mattthebaker/ewall-board/ClimbingWallController.brd

## EAGLE design ClimbingWallController.brd (2013-03-25)

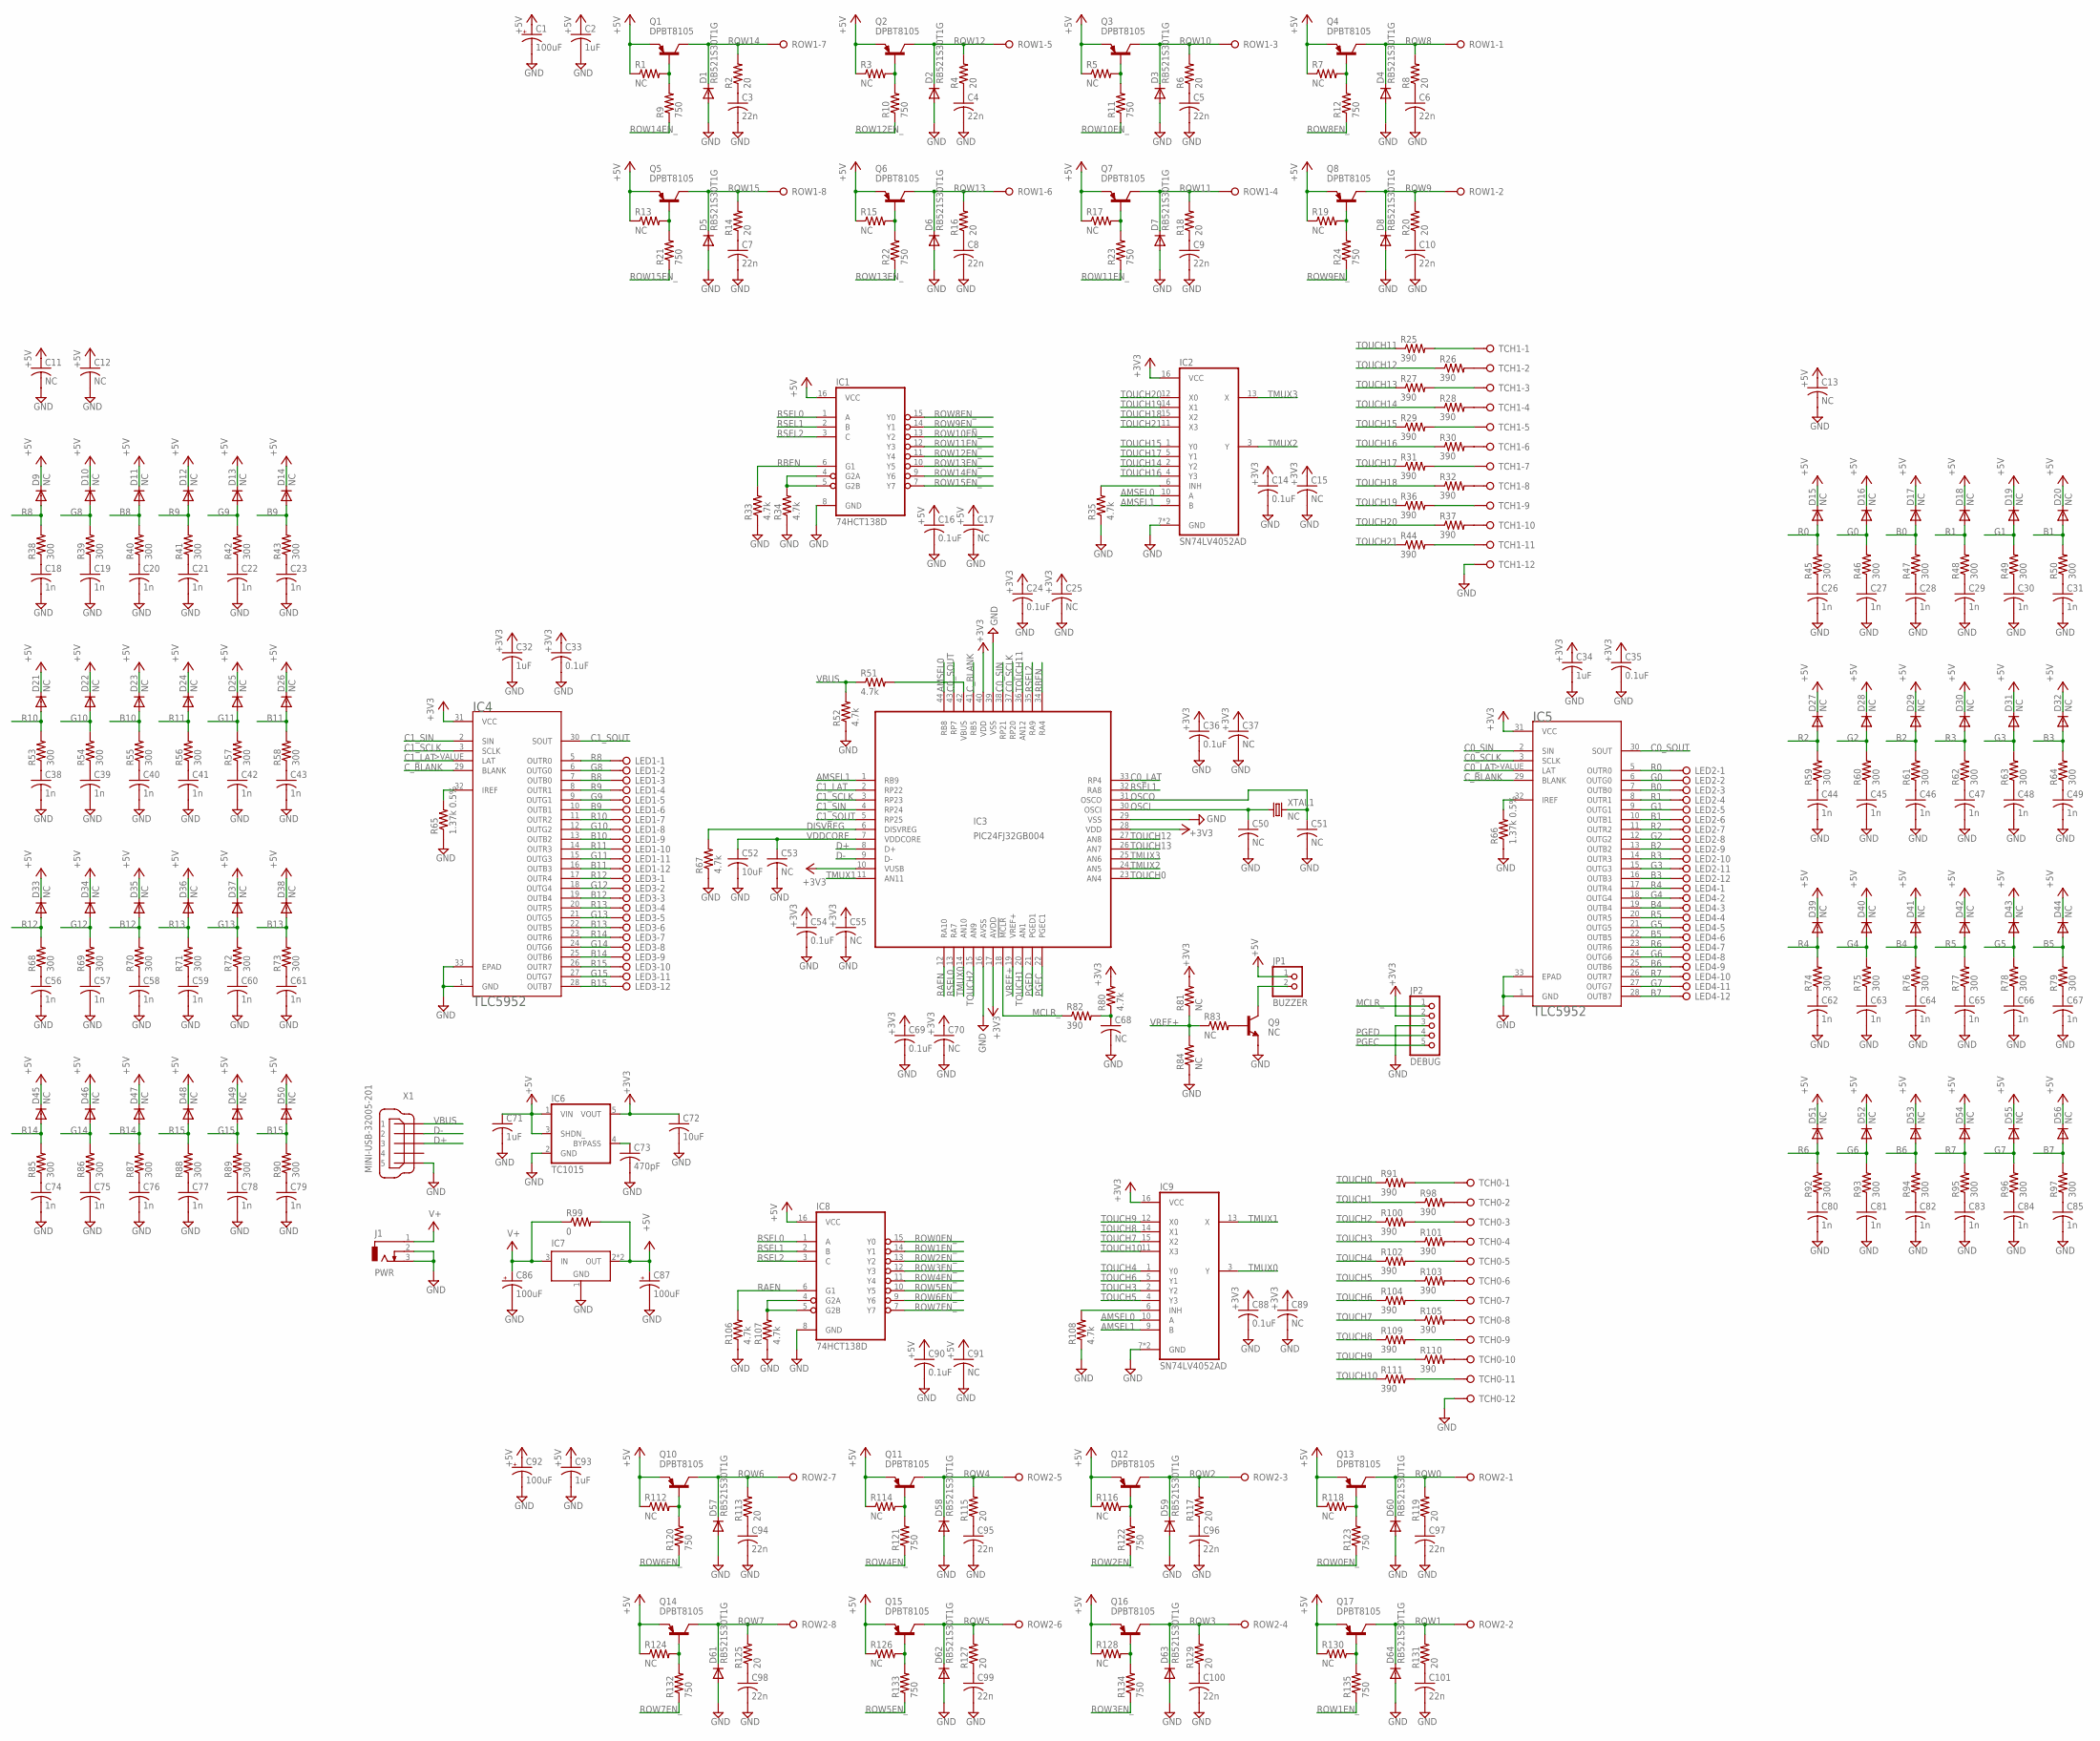
[picture p1: schematic ClimbingWallController.sch]

Parts:
C1, C86, C87, C92: 100uF; PANASONIC_D
C2, C32, C34, C71, C93: 1uF; C0603K
C3, C4, C5, C6, C7, C8, C9, C10, C94, C95, C96, C97, C98, C99, C100, C101: 22n; C0603K
C11, C12, C13, C15, C17, C25, C37, C50, C51, C53, C55, C68, C70, C89, C91: NC; C0603K
C14, C16, C24, C33, C35, C36, C54, C69, C88, C90: 0.1uF; C0603K
C18, C19, C20, C21, C22, C23, C26, C27, C28, C29, C30, C31, C38, C39, C40, C41, C42, C43, C44, C45, C46, C47, C48, C49, C56, C57, C58, C59, C60, C61, C62, C63, C64, C65, C66, C67, C74, C75, C76, C77, C78, C79, C80, C81, C82, C83, C84, C85: 1n; C0603K
C52, C72: 10uF; C1206K
C73: 470pF; C0603K
D1, D2, D3, D4, D5, D6, D7, D8, D57, D58, D59, D60, D61, D62, D63, D64: RB521S30T1G; SOD523
D9, D10, D11, D12, D13, D14, D15, D16, D17, D18, D19, D20, D21, D22, D23, D24, D25, D26, D27, D28, D29, D30, D31, D32, D33, D34, D35, D36, D37, D38, D39, D40, D41, D42, D43, D44, D45, D46, D47, D48, D49, D50, D51, D52, D53, D54, D55, D56: NC; SOD523
IC1, IC8: 74HCT138D; SO16
IC2, IC9: SN74LV4052AD; SO16
IC3: PIC24FJ32GB004; TQFP44
IC4, IC5: TLC5952; HTSSOP-32POWERPAD
IC6: TC1015; SOT23-5L
IC7: NCP1117; SOT223
J1: PWR; DCJ0303
JP1: BUZZER; 1X02
JP2: DEBUG; 1X05
LED1, LED2, LED3, LED4: OSTVN12A150; OSTVN12
Q1, Q2, Q3, Q4, Q5, Q6, Q7, Q8, Q10, Q11, Q12, Q13, Q14, Q15, Q16, Q17: DPBT8105; SOT23
Q9: NC; SOT23-BEC
R1, R3, R5, R7, R13, R15, R17, R19, R81, R83, R84, R112, R114, R116, R118, R124, R126, R128, R130: NC; R0603
R2, R4, R6, R8, R14, R16, R18, R20, R113, R115, R117, R119, R125, R127, R129, R131: 20; R0603
R9, R10, R11, R12, R21, R22, R23, R24, R120, R121, R122, R123, R132, R133, R134, R135: 750; R0603
R25, R26, R27, R28, R29, R30, R31, R32, R36, R37, R44, R82, R91, R98, R100, R101, R102, R103, R104, R105, R109, R110, R111: 390; R0603
R33, R34, R35, R51, R52, R67, R80, R106, R107, R108: 4.7k; R0603
R38, R39, R40, R41, R42, R43, R45, R46, R47, R48, R49, R50, R53, R54, R55, R56, R57, R58, R59, R60, R61, R62, R63, R64, R68, R69, R70, R71, R72, R73, R74, R75, R76, R77, R78, R79, R85, R86, R87, R88, R89, R90, R92, R93, R94, R95, R96, R97: 300; R0603
R65, R66: 1.37k 0.5%; R0805; TOLERANCE 0.5%
R99: 0; R0805
ROW1, ROW2: OSTVN08A150; OSTVN08
TCH0, TCH1: OSTVN12A150; OSTVN12
X1: MINI-USB-32005-201; 32005-201; MPN USB-M26FTR
XTAL1: NC; NX5032; MPN 7A-12.000MAAJ-T

Connections:
+3V3: C14.1, C15.1, C24.1, C25.1, C32.1, C33.1, C34.1, C35.1, C36.1, C37.1, C54.1, C55.1, C69.1, C70.1, C72.1, C88.1, C89.1, IC2.16 (VCC), IC3.10 (VUSB), IC3.17 (AVDD), IC3.28 (VDD), IC3.40 (VDD), IC4.31 (VCC), IC5.31 (VCC), IC6.5 (VOUT), IC9.16 (VCC), JP2.2, R80.2, R81.2
+5V: C1.+, C2.1, C11.1, C12.1, C13.1, C16.1, C17.1, C71.1, C87.+, C90.1, C91.1, C92.+, C93.1, D9.C, D10.C, D11.C, D12.C, D13.C, D14.C, D15.C, D16.C, D17.C, D18.C, D19.C, D20.C, D21.C, D22.C, D23.C, D24.C, D25.C, D26.C, D27.C, D28.C, D29.C, D30.C, D31.C, D32.C, D33.C, D34.C, D35.C, D36.C, D37.C, D38.C, D39.C, D40.C, D41.C, D42.C, D43.C, D44.C, D45.C, D46.C, D47.C, D48.C, D49.C, D50.C, D51.C, D52.C, D53.C, D54.C, D55.C, D56.C, IC1.16 (VCC), IC6.1 (VIN), IC6.3 (SHDN_), IC7.2 (OUT), IC7.4 (OUT), IC8.16 (VCC), JP1.1, Q1.2 (E), Q2.2 (E), Q3.2 (E), Q4.2 (E), Q5.2 (E), Q6.2 (E), Q7.2 (E), Q8.2 (E), Q10.2 (E), Q11.2 (E), Q12.2 (E), Q13.2 (E), Q14.2 (E), Q15.2 (E), Q16.2 (E), Q17.2 (E), R1.1, R3.1, R5.1, R7.1, R13.1, R15.1, R17.1, R19.1, R99.2, R112.1, R114.1, R116.1, R118.1, R124.1, R126.1, R128.1, R130.1
AMSEL0: IC2.10 (A), IC3.44 (RB8), IC9.10 (A)
AMSEL1: IC2.9 (B), IC3.1 (RB9), IC9.9 (B)
B0: D17.A, IC5.7 (OUTB0), LED2.3, R47.2
B1: D20.A, IC5.10 (OUTB1), LED2.6, R50.2
B2: D29.A, IC5.13 (OUTB2), LED2.9, R61.2
B3: D32.A, IC5.16 (OUTB3), LED2.12, R64.2
B4: D41.A, IC5.19 (OUTB4), LED4.3, R76.2
B5: D44.A, IC5.22 (OUTB5), LED4.6, R79.2
B6: D53.A, IC5.25 (OUTB6), LED4.9, R94.2
B7: D56.A, IC5.28 (OUTB7), LED4.12, R97.2
B8: D11.A, IC4.7 (OUTB0), LED1.3, R40.2
B9: D14.A, IC4.10 (OUTB1), LED1.6, R43.2
B10: D23.A, IC4.13 (OUTB2), LED1.9, R55.2
B11: D26.A, IC4.16 (OUTB3), LED1.12, R58.2
B12: D35.A, IC4.19 (OUTB4), LED3.3, R70.2
B13: D38.A, IC4.22 (OUTB5), LED3.6, R73.2
B14: D47.A, IC4.25 (OUTB6), LED3.9, R87.2
B15: D50.A, IC4.28 (OUTB7), LED3.12, R90.2
C0_LAT: IC3.33 (RP4), IC5.>VALUE (LAT)
C0_SCLK: IC3.37 (RP20), IC5.3 (SCLK)
C0_SIN: IC3.38 (RP21), IC5.2 (SIN)
C0_SOUT: IC3.43 (RP7), IC5.30 (SOUT)
C1_LAT: IC3.2 (RP22), IC4.>VALUE (LAT)
C1_SCLK: IC3.3 (RP23), IC4.3 (SCLK)
C1_SIN: IC3.4 (RP24), IC4.2 (SIN)
C1_SOUT: IC3.5 (RP25), IC4.30 (SOUT)
CAIREF: IC5.32 (IREF), R66.2
CAIREF1: IC4.32 (IREF), R65.2
C_BLANK: IC3.41 (RB5), IC4.29 (BLANK), IC5.29 (BLANK)
D+: IC3.8 (D+), X1.3
D-: IC3.9 (D-), X1.2
DISVREG: IC3.6 (DISVREG), R67.2
G0: D16.A, IC5.6 (OUTG0), LED2.2, R46.2
G1: D19.A, IC5.9 (OUTG1), LED2.5, R49.2
G2: D28.A, IC5.12 (OUTG2), LED2.8, R60.2
G3: D31.A, IC5.15 (OUTG3), LED2.11, R63.2
G4: D40.A, IC5.18 (OUTG4), LED4.2, R75.2
G5: D43.A, IC5.21 (OUTG5), LED4.5, R78.2
G6: D52.A, IC5.24 (OUTG6), LED4.8, R93.2
G7: D55.A, IC5.27 (OUTG7), LED4.11, R96.2
G8: D10.A, IC4.6 (OUTG0), LED1.2, R39.2
G9: D13.A, IC4.9 (OUTG1), LED1.5, R42.2
G10: D22.A, IC4.12 (OUTG2), LED1.8, R54.2
G11: D25.A, IC4.15 (OUTG3), LED1.11, R57.2
G12: D34.A, IC4.18 (OUTG4), LED3.2, R69.2
G13: D37.A, IC4.21 (OUTG5), LED3.5, R72.2
G14: D46.A, IC4.24 (OUTG6), LED3.8, R86.2
G15: D49.A, IC4.27 (OUTG7), LED3.11, R89.2
GND: C1.-, C2.2, C3.2, C4.2, C5.2, C6.2, C7.2, C8.2, C9.2, C10.2, C11.2, C12.2, C13.2, C14.2, C15.2, C16.2, C17.2, C18.2, C19.2, C20.2, C21.2, C22.2, C23.2, C24.2, C25.2, C26.2, C27.2, C28.2, C29.2, C30.2, C31.2, C32.2, C33.2, C34.2, C35.2, C36.2, C37.2, C38.2, C39.2, C40.2, C41.2, C42.2, C43.2, C44.2, C45.2, C46.2, C47.2, C48.2, C49.2, C50.2, C51.2, C52.2, C53.2, C54.2, C55.2, C56.2, C57.2, C58.2, C59.2, C60.2, C61.2, C62.2, C63.2, C64.2, C65.2, C66.2, C67.2, C68.2, C69.2, C70.2, C71.2, C72.2, C73.2, C74.2, C75.2, C76.2, C77.2, C78.2, C79.2, C80.2, C81.2, C82.2, C83.2, C84.2, C85.2, C86.-, C87.-, C88.2, C89.2, C90.2, C91.2, C92.-, C93.2, C94.2, C95.2, C96.2, C97.2, C98.2, C99.2, C100.2, C101.2, D1.A, D2.A, D3.A, D4.A, D5.A, D6.A, D7.A, D8.A, D57.A, D58.A, D59.A, D60.A, D61.A, D62.A, D63.A, D64.A, IC1.8 (GND), IC2.7 (GND), IC2.8 (GND), IC3.16 (AVSS), IC3.29 (VSS), IC3.39 (VSS), IC4.1 (GND), IC4.33 (EPAD), IC5.1 (GND), IC5.33 (EPAD), IC6.2 (GND), IC7.1 (GND), IC8.8 (GND), IC9.7 (GND), IC9.8 (GND), J1.2, J1.3, JP2.3, Q9.E, R33.1, R34.1, R35.1, R52.1, R65.1, R66.1, R67.1, R84.1, R106.1, R107.1, R108.1, TCH0.12, TCH1.12, X1.5
MCLR_: IC3.18 (!MCLR), JP2.1, R82.1
unnamed: Q13.1 (B), R118.2, R123.2
unnamed: C97.1, R119.1
unnamed: Q12.1 (B), R116.2, R122.2
unnamed: C96.1, R117.1
unnamed: Q16.1 (B), R128.2, R134.2
unnamed: C100.1, R129.1
unnamed: Q15.1 (B), R126.2, R133.2
unnamed: C99.1, R127.1
unnamed: Q11.1 (B), R114.2, R121.2
unnamed: C95.1, R115.1
unnamed: Q10.1 (B), R112.2, R120.2
unnamed: C94.1, R113.1
unnamed: Q14.1 (B), R124.2, R132.2
unnamed: C98.1, R125.1
unnamed: Q8.1 (B), R19.2, R24.2
unnamed: C10.1, R20.1
unnamed: Q4.1 (B), R7.2, R12.2
unnamed: C6.1, R8.1
unnamed: Q3.1 (B), R5.2, R11.2
unnamed: C5.1, R6.1
unnamed: Q7.1 (B), R17.2, R23.2
unnamed: C9.1, R18.1
unnamed: Q6.1 (B), R15.2, R22.2
unnamed: C8.1, R16.1
unnamed: Q2.1 (B), R3.2, R10.2
unnamed: C4.1, R4.1
unnamed: Q1.1 (B), R1.2, R9.2
unnamed: C3.1, R2.1
unnamed: Q5.1 (B), R13.2, R21.2
unnamed: C7.1, R14.1
unnamed: R98.2, TCH0.2
unnamed: R101.2, TCH0.4
unnamed: Q17.1 (B), R130.2, R135.2
unnamed: C101.1, R131.1
unnamed: R103.2, TCH0.6
unnamed: R105.2, TCH0.8
unnamed: R110.2, TCH0.10
unnamed: R26.2, TCH1.2
unnamed: R28.2, TCH1.4
unnamed: R30.2, TCH1.6
unnamed: IC8.4 (G2A), IC8.5 (G2B), R107.2
unnamed: IC9.6 (INH), R108.2
unnamed: IC1.4 (G2A), IC1.5 (G2B), R34.2
unnamed: IC2.6 (INH), R35.2
unnamed: IC3.42 (VBUS), R51.2
unnamed: C68.1, R80.1, R82.2
unnamed: R91.2, TCH0.1
unnamed: R32.2, TCH1.8
unnamed: R37.2, TCH1.10
unnamed: Q9.B, R83.2
unnamed: R100.2, TCH0.3
unnamed: R102.2, TCH0.5
unnamed: R104.2, TCH0.7
unnamed: R109.2, TCH0.9
unnamed: R111.2, TCH0.11
unnamed: R25.2, TCH1.1
unnamed: R27.2, TCH1.3
unnamed: R29.2, TCH1.5
unnamed: R31.2, TCH1.7
unnamed: R36.2, TCH1.9
unnamed: R44.2, TCH1.11
unnamed: C73.1, IC6.4 (BYPASS)
unnamed: JP1.2, Q9.C
unnamed: C26.1, R45.1
unnamed: C27.1, R46.1
unnamed: C28.1, R47.1
unnamed: C29.1, R48.1
unnamed: C30.1, R49.1
unnamed: C31.1, R50.1
unnamed: C44.1, R59.1
unnamed: C45.1, R60.1
unnamed: C46.1, R61.1
unnamed: C47.1, R62.1
unnamed: C48.1, R63.1
unnamed: C49.1, R64.1
unnamed: C62.1, R74.1
unnamed: C63.1, R75.1
unnamed: C64.1, R76.1
unnamed: C65.1, R77.1
unnamed: C66.1, R78.1
unnamed: C67.1, R79.1
unnamed: C80.1, R92.1
unnamed: C81.1, R93.1
unnamed: C82.1, R94.1
unnamed: C83.1, R95.1
unnamed: C84.1, R96.1
unnamed: C85.1, R97.1
unnamed: C18.1, R38.1
unnamed: C19.1, R39.1
unnamed: C20.1, R40.1
unnamed: C21.1, R41.1
unnamed: C22.1, R42.1
unnamed: C23.1, R43.1
unnamed: C38.1, R53.1
unnamed: C39.1, R54.1
unnamed: C40.1, R55.1
unnamed: C41.1, R56.1
unnamed: C42.1, R57.1
unnamed: C43.1, R58.1
unnamed: C56.1, R68.1
unnamed: C57.1, R69.1
unnamed: C58.1, R70.1
unnamed: C59.1, R71.1
unnamed: C60.1, R72.1
unnamed: C61.1, R73.1
unnamed: C74.1, R85.1
unnamed: C75.1, R86.1
unnamed: C76.1, R87.1
unnamed: C77.1, R88.1
unnamed: C78.1, R89.1
unnamed: C79.1, R90.1
OSCI: C50.1, IC3.30 (OSCI), XTAL1.P$1 (1)
OSCO: C51.1, IC3.31 (OSCO), XTAL1.P$2 (2)
PGEC: IC3.22 (PGEC1), JP2.5
PGED: IC3.21 (PGED1), JP2.4
R0: D15.A, IC5.5 (OUTR0), LED2.1, R45.2
R1: D18.A, IC5.8 (OUTR1), LED2.4, R48.2
R2: D27.A, IC5.11 (OUTR2), LED2.7, R59.2
R3: D30.A, IC5.14 (OUTR3), LED2.10, R62.2
R4: D39.A, IC5.17 (OUTR4), LED4.1, R74.2
R5: D42.A, IC5.20 (OUTR5), LED4.4, R77.2
R6: D51.A, IC5.23 (OUTR6), LED4.7, R92.2
R7: D54.A, IC5.26 (OUTR7), LED4.10, R95.2
R8: D9.A, IC4.5 (OUTR0), LED1.1, R38.2
R9: D12.A, IC4.8 (OUTR1), LED1.4, R41.2
R10: D21.A, IC4.11 (OUTR2), LED1.7, R53.2
R11: D24.A, IC4.14 (OUTR3), LED1.10, R56.2
R12: D33.A, IC4.17 (OUTR4), LED3.1, R68.2
R13: D36.A, IC4.20 (OUTR5), LED3.4, R71.2
R14: D45.A, IC4.23 (OUTR6), LED3.7, R85.2
R15: D48.A, IC4.26 (OUTR7), LED3.10, R88.2
RAEN: IC3.12 (RA10), IC8.6 (G1), R106.2
RBEN: IC1.6 (G1), IC3.34 (RA4), R33.2
ROW0: D60.C, Q13.3 (C), R119.2, ROW2.1
ROW0EN_: IC8.15 (Y0), R123.1
ROW1: D64.C, Q17.3 (C), R131.2, ROW2.2
ROW1EN_: IC8.14 (Y1), R135.1
ROW2: D59.C, Q12.3 (C), R117.2, ROW2.3
ROW2EN_: IC8.13 (Y2), R122.1
ROW3: D63.C, Q16.3 (C), R129.2, ROW2.4
ROW3EN_: IC8.12 (Y3), R134.1
ROW4: D58.C, Q11.3 (C), R115.2, ROW2.5
ROW4EN_: IC8.11 (Y4), R121.1
ROW5: D62.C, Q15.3 (C), R127.2, ROW2.6
ROW5EN_: IC8.10 (Y5), R133.1
ROW6: D57.C, Q10.3 (C), R113.2, ROW2.7
ROW6EN_: IC8.9 (Y6), R120.1
ROW7: D61.C, Q14.3 (C), R125.2, ROW2.8
ROW7EN_: IC8.7 (Y7), R132.1
ROW8: D4.C, Q4.3 (C), R8.2, ROW1.1
ROW8EN_: IC1.15 (Y0), R12.1
ROW9: D8.C, Q8.3 (C), R20.2, ROW1.2
ROW9EN_: IC1.14 (Y1), R24.1
ROW10: D3.C, Q3.3 (C), R6.2, ROW1.3
ROW10EN_: IC1.13 (Y2), R11.1
ROW11: D7.C, Q7.3 (C), R18.2, ROW1.4
ROW11EN_: IC1.12 (Y3), R23.1
ROW12: D2.C, Q2.3 (C), R4.2, ROW1.5
ROW12EN_: IC1.11 (Y4), R10.1
ROW13: D6.C, Q6.3 (C), R16.2, ROW1.6
ROW13EN_: IC1.10 (Y5), R22.1
ROW14: D1.C, Q1.3 (C), R2.2, ROW1.7
ROW14EN_: IC1.9 (Y6), R9.1
ROW15: D5.C, Q5.3 (C), R14.2, ROW1.8
ROW15EN_: IC1.7 (Y7), R21.1
RSEL0: IC1.1 (A), IC3.13 (RA7), IC8.1 (A)
RSEL1: IC1.2 (B), IC3.32 (RA8), IC8.2 (B)
RSEL2: IC1.3 (C), IC3.35 (RA9), IC8.3 (C)
TMUX0: IC3.14 (AN10), IC9.3 (Y)
TMUX1: IC3.11 (AN11), IC9.13 (X)
TMUX2: IC2.3 (Y), IC3.24 (AN5)
TMUX3: IC2.13 (X), IC3.25 (AN6)
TOUCH0: IC3.23 (AN4), R91.1
TOUCH1: IC3.20 (AN1), R98.1
TOUCH2: IC3.15 (AN9), R100.1
TOUCH3: IC9.2 (Y2), R101.1
TOUCH4: IC9.1 (Y0), R102.1
TOUCH5: IC9.4 (Y3), R103.1
TOUCH6: IC9.5 (Y1), R104.1
TOUCH7: IC9.15 (X2), R105.1
TOUCH8: IC9.14 (X1), R109.1
TOUCH9: IC9.12 (X0), R110.1
TOUCH10: IC9.11 (X3), R111.1
TOUCH11: IC3.36 (AN12), R25.1
TOUCH12: IC3.27 (AN8), R26.1
TOUCH13: IC3.26 (AN7), R27.1
TOUCH14: IC2.2 (Y2), R28.1
TOUCH15: IC2.1 (Y0), R29.1
TOUCH16: IC2.4 (Y3), R30.1
TOUCH17: IC2.5 (Y1), R31.1
TOUCH18: IC2.15 (X2), R32.1
TOUCH19: IC2.14 (X1), R36.1
TOUCH20: IC2.12 (X0), R37.1
TOUCH21: IC2.11 (X3), R44.1
V+: C86.+, IC7.3 (IN), J1.1, R99.1
VBUS: R51.1, R52.2, X1.1
VDDCORE: C52.1, C53.1, IC3.7 (VDDCORE)
VREF+: IC3.19 (VREF+), R81.1, R83.1, R84.2

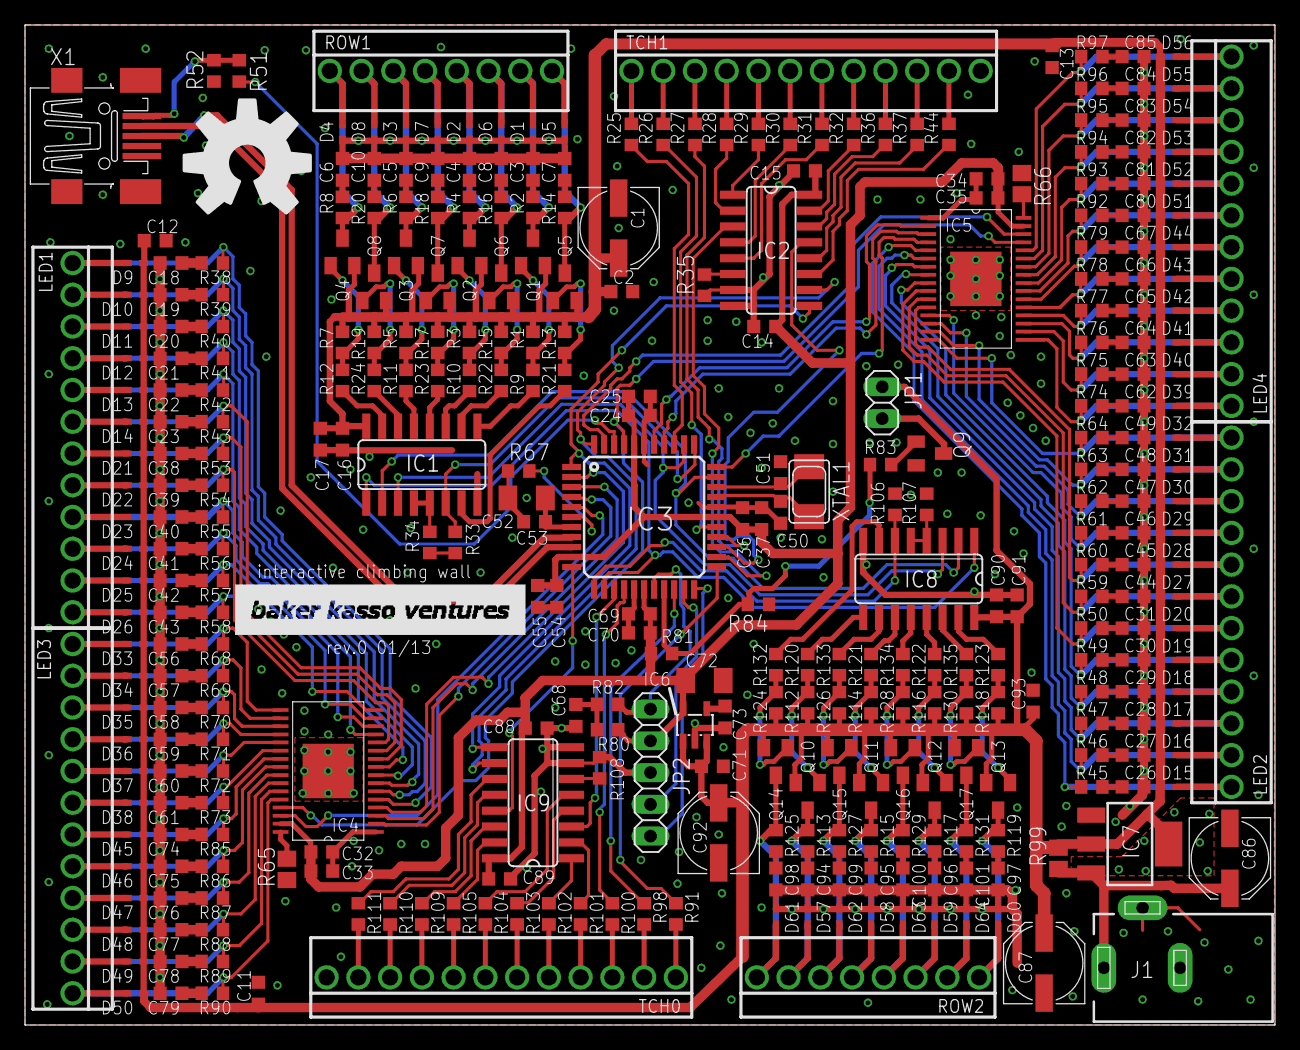
[picture p2: board ClimbingWallController.brd from above]

Board: 2 copper layers, 100.0 x 80.0 mm, 339 parts (0 on the bottom side), 250 nets.
