mattthebaker/ewall-board/RowDriver4.brd

## EAGLE design RowDriver4.brd (2013-01-11)

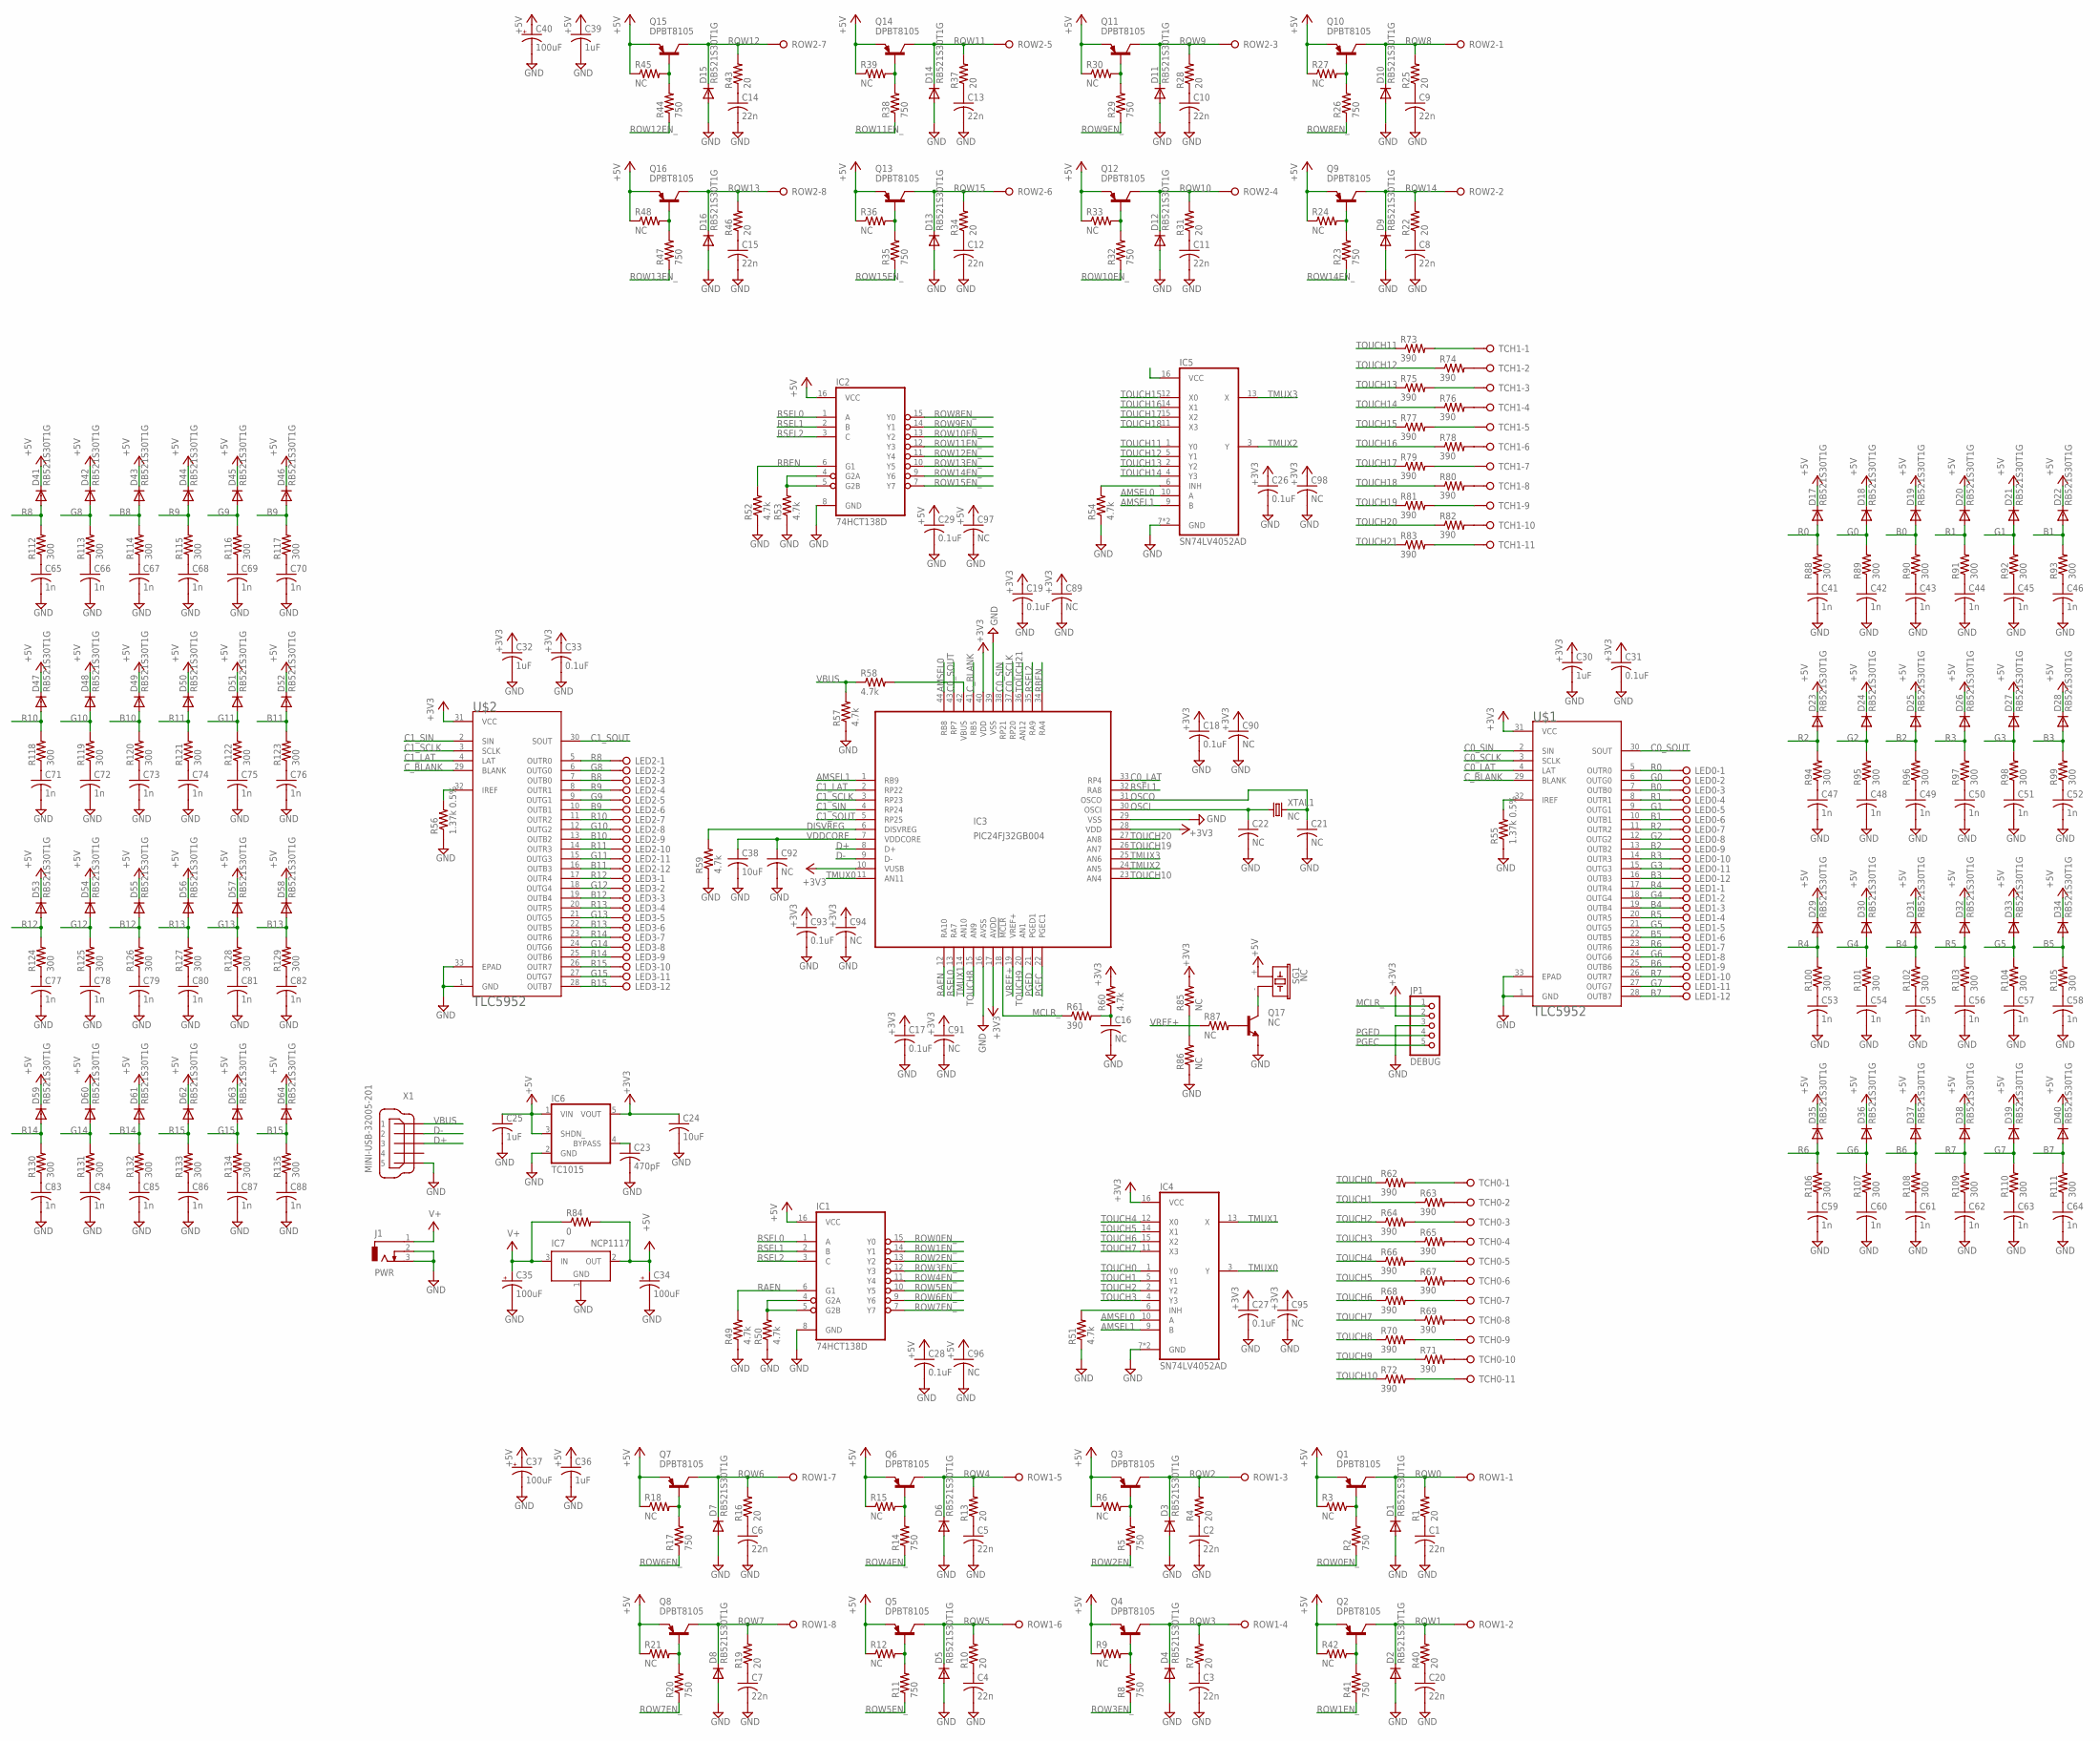
[picture p3: schematic RowDriver4.sch]

Parts:
C1, C2, C3, C4, C5, C6, C7, C8, C9, C10, C11, C12, C13, C14, C15, C20: 22n; C0603
C16, C21, C22, C89, C90, C91, C92, C94, C95, C96, C97, C98: NC; C0805
C17, C18, C19, C26, C27, C28, C29, C31, C33, C93: 0.1uF; C0805
C23: 470pF; C0805
C24, C38: 10uF; C1206K
C25, C30, C32, C36, C39: 1uF; C0805
C34, C35, C37, C40: 100uF; PANASONIC_D
C41, C42, C43, C44, C45, C46, C47, C48, C49, C50, C51, C52, C53, C54, C55, C56, C57, C58, C59, C60, C61, C62, C63, C64, C65, C66, C67, C68, C69, C70, C71, C72, C73, C74, C75, C76, C77, C78, C79, C80, C81, C82, C83, C84, C85, C86, C87, C88: 1n; C0805
D1, D2, D3, D4, D5, D6, D7, D8, D9, D10, D11, D12, D13, D14, D15, D16, D17, D18, D19, D20, D21, D22, D23, D24, D25, D26, D27, D28, D29, D30, D31, D32, D33, D34, D35, D36, D37, D38, D39, D40, D41, D42, D43, D44, D45, D46, D47, D48, D49, D50, D51, D52, D53, D54, D55, D56, D57, D58, D59, D60, D61, D62, D63, D64: RB521S30T1G; SOD523
IC1, IC2: 74HCT138D; SO16
IC3: PIC24FJ32GB004; TQFP44
IC4, IC5: SN74LV4052AD; SO16
IC6: TC1015; SOT23-5L
IC7: NCP1117; SOT223
J1: PWR; DCJ0303
JP1: DEBUG; 1X05/90
LED0, LED1, LED2, LED3: OSTVN12A150; OSTVN12
Q1, Q2, Q3, Q4, Q5, Q6, Q7, Q8, Q9, Q10, Q11, Q12, Q13, Q14, Q15, Q16: DPBT8105; SOT23
Q17: NC; SOT23-EBC
R1, R4, R7, R10, R13, R16, R19, R22, R25, R28, R31, R34, R37, R40, R43, R46: 20; R0603
R2, R5, R8, R11, R14, R17, R20, R23, R26, R29, R32, R35, R38, R41, R44, R47: 750; R0603
R3, R6, R9, R12, R15, R18, R21, R24, R27, R30, R33, R36, R39, R42, R45, R48: NC; R0603
R49, R50, R51, R52, R53, R54, R57, R58, R59, R60: 4.7k; R0805
R55, R56: 1.37k 0.5%; R0805
R61, R62, R63, R64, R65, R66, R67, R68, R69, R70, R71, R72, R73, R74, R75, R76, R77, R78, R79, R80, R81, R82, R83: 390; R0805
R84: 0; R0805
R85, R86, R87: NC; R0805
R88, R89, R90, R91, R92, R93, R94, R95, R96, R97, R98, R99, R100, R101, R102, R103, R104, R105, R106, R107, R108, R109, R110, R111, R112, R113, R114, R115, R116, R117, R118, R119, R120, R121, R122, R123, R124, R125, R126, R127, R128, R129, R130, R131, R132, R133, R134, R135: 300; R0805
ROW1, ROW2: OSTVN08A150; OSTVN08
SG1: NC; F/CM04P
TCH0, TCH1: OSTVN11A150; OSTVN11
U$1, U$2: TLC5952; HTSSOP-32POWERPAD
X1: MINI-USB-32005-201; 32005-201
XTAL1: NC; HC49UP

Connections:
+3V3: C17.1, C18.1, C19.1, C24.1, C26.1, C27.1, C30.1, C31.1, C32.1, C33.1, C89.1, C90.1, C91.1, C93.1, C94.1, C95.1, C98.1, IC3.10 (VUSB), IC3.17 (AVDD), IC3.28 (VDD), IC3.40 (VDD), IC4.16 (VCC), IC5.16 (VCC), IC6.5 (VOUT), JP1.2, R60.2, R85.2, U$1.31 (VCC), U$2.31 (VCC)
+5V: C25.1, C28.1, C29.1, C34.+, C36.1, C37.+, C39.1, C40.+, C96.1, C97.1, D17.C, D18.C, D19.C, D20.C, D21.C, D22.C, D23.C, D24.C, D25.C, D26.C, D27.C, D28.C, D29.C, D30.C, D31.C, D32.C, D33.C, D34.C, D35.C, D36.C, D37.C, D38.C, D39.C, D40.C, D41.C, D42.C, D43.C, D44.C, D45.C, D46.C, D47.C, D48.C, D49.C, D50.C, D51.C, D52.C, D53.C, D54.C, D55.C, D56.C, D57.C, D58.C, D59.C, D60.C, D61.C, D62.C, D63.C, D64.C, IC1.16 (VCC), IC2.16 (VCC), IC6.1 (VIN), IC6.3 (SHDN_), IC7.2 (OUT), Q1.2 (E), Q2.2 (E), Q3.2 (E), Q4.2 (E), Q5.2 (E), Q6.2 (E), Q7.2 (E), Q8.2 (E), Q9.2 (E), Q10.2 (E), Q11.2 (E), Q12.2 (E), Q13.2 (E), Q14.2 (E), Q15.2 (E), Q16.2 (E), R3.1, R6.1, R9.1, R12.1, R15.1, R18.1, R21.1, R24.1, R27.1, R30.1, R33.1, R36.1, R39.1, R42.1, R45.1, R48.1, R84.2, SG1.+ (1)
AMSEL0: IC3.44 (RB8), IC4.10 (A), IC5.10 (A)
AMSEL1: IC3.1 (RB9), IC4.9 (B), IC5.9 (B)
B0: D19.A, LED0.3, R90.2, U$1.7 (OUTB0)
B1: D22.A, LED0.6, R93.2, U$1.10 (OUTB1)
B2: D25.A, LED0.9, R96.2, U$1.13 (OUTB2)
B3: D28.A, LED0.12, R99.2, U$1.16 (OUTB3)
B4: D31.A, LED1.3, R102.2, U$1.19 (OUTB4)
B5: D34.A, LED1.6, R105.2, U$1.22 (OUTB5)
B6: D37.A, LED1.9, R108.2, U$1.25 (OUTB6)
B7: D40.A, LED1.12, R111.2, U$1.28 (OUTB7)
B8: D43.A, LED2.3, R114.2, U$2.7 (OUTB0)
B9: D46.A, LED2.6, R117.2, U$2.10 (OUTB1)
B10: D49.A, LED2.9, R120.2, U$2.13 (OUTB2)
B11: D52.A, LED2.12, R123.2, U$2.16 (OUTB3)
B12: D55.A, LED3.3, R126.2, U$2.19 (OUTB4)
B13: D58.A, LED3.6, R129.2, U$2.22 (OUTB5)
B14: D61.A, LED3.9, R132.2, U$2.25 (OUTB6)
B15: D64.A, LED3.12, R135.2, U$2.28 (OUTB7)
C0_LAT: IC3.33 (RP4), U$1.4 (LAT)
C0_SCLK: IC3.37 (RP20), U$1.3 (SCLK)
C0_SIN: IC3.38 (RP21), U$1.2 (SIN)
C0_SOUT: IC3.43 (RP7), U$1.30 (SOUT)
C1_LAT: IC3.2 (RP22), U$2.4 (LAT)
C1_SCLK: IC3.3 (RP23), U$2.3 (SCLK)
C1_SIN: IC3.4 (RP24), U$2.2 (SIN)
C1_SOUT: IC3.5 (RP25), U$2.30 (SOUT)
CAIREF: R55.2, U$1.32 (IREF)
CAIREF1: R56.2, U$2.32 (IREF)
C_BLANK: IC3.41 (RB5), U$1.29 (BLANK), U$2.29 (BLANK)
D+: IC3.8 (D+), X1.3
D-: IC3.9 (D-), X1.2
DISVREG: IC3.6 (DISVREG), R59.2
G0: D18.A, LED0.2, R89.2, U$1.6 (OUTG0)
G1: D21.A, LED0.5, R92.2, U$1.9 (OUTG1)
G2: D24.A, LED0.8, R95.2, U$1.12 (OUTG2)
G3: D27.A, LED0.11, R98.2, U$1.15 (OUTG3)
G4: D30.A, LED1.2, R101.2, U$1.18 (OUTG4)
G5: D33.A, LED1.5, R104.2, U$1.21 (OUTG5)
G6: D36.A, LED1.8, R107.2, U$1.24 (OUTG6)
G7: D39.A, LED1.11, R110.2, U$1.27 (OUTG7)
G8: D42.A, LED2.2, R113.2, U$2.6 (OUTG0)
G9: D45.A, LED2.5, R116.2, U$2.9 (OUTG1)
G10: D48.A, LED2.8, R119.2, U$2.12 (OUTG2)
G11: D51.A, LED2.11, R122.2, U$2.15 (OUTG3)
G12: D54.A, LED3.2, R125.2, U$2.18 (OUTG4)
G13: D57.A, LED3.5, R128.2, U$2.21 (OUTG5)
G14: D60.A, LED3.8, R131.2, U$2.24 (OUTG6)
G15: D63.A, LED3.11, R134.2, U$2.27 (OUTG7)
GND: C1.2, C2.2, C3.2, C4.2, C5.2, C6.2, C7.2, C8.2, C9.2, C10.2, C11.2, C12.2, C13.2, C14.2, C15.2, C16.2, C17.2, C18.2, C19.2, C20.2, C21.2, C22.2, C23.2, C24.2, C25.2, C26.2, C27.2, C28.2, C29.2, C30.2, C31.2, C32.2, C33.2, C34.-, C35.-, C36.2, C37.-, C38.2, C39.2, C40.-, C41.2, C42.2, C43.2, C44.2, C45.2, C46.2, C47.2, C48.2, C49.2, C50.2, C51.2, C52.2, C53.2, C54.2, C55.2, C56.2, C57.2, C58.2, C59.2, C60.2, C61.2, C62.2, C63.2, C64.2, C65.2, C66.2, C67.2, C68.2, C69.2, C70.2, C71.2, C72.2, C73.2, C74.2, C75.2, C76.2, C77.2, C78.2, C79.2, C80.2, C81.2, C82.2, C83.2, C84.2, C85.2, C86.2, C87.2, C88.2, C89.2, C90.2, C91.2, C92.2, C93.2, C94.2, C95.2, C96.2, C97.2, C98.2, D1.A, D2.A, D3.A, D4.A, D5.A, D6.A, D7.A, D8.A, D9.A, D10.A, D11.A, D12.A, D13.A, D14.A, D15.A, D16.A, IC1.8 (GND), IC2.8 (GND), IC3.16 (AVSS), IC3.29 (VSS), IC3.39 (VSS), IC4.7 (GND), IC4.8 (GND), IC5.7 (GND), IC5.8 (GND), IC6.2 (GND), IC7.1 (GND), IC7.4 (GND), J1.2, J1.3, JP1.3, Q17.E, R49.1, R50.1, R51.1, R52.1, R53.1, R54.1, R55.1, R56.1, R57.1, R59.1, R86.1, U$1.1 (GND), U$1.33 (EPAD), U$2.1 (GND), U$2.33 (EPAD), X1.5
MCLR_: IC3.18 (!MCLR), JP1.1, R61.1
unnamed: Q1.1 (B), R2.2, R3.2
unnamed: C1.1, R1.1
unnamed: Q3.1 (B), R5.2, R6.2
unnamed: C2.1, R4.1
unnamed: Q4.1 (B), R8.2, R9.2
unnamed: C3.1, R7.1
unnamed: Q5.1 (B), R11.2, R12.2
unnamed: C4.1, R10.1
unnamed: Q6.1 (B), R14.2, R15.2
unnamed: C5.1, R13.1
unnamed: Q7.1 (B), R17.2, R18.2
unnamed: C6.1, R16.1
unnamed: Q8.1 (B), R20.2, R21.2
unnamed: C7.1, R19.1
unnamed: Q9.1 (B), R23.2, R24.2
unnamed: C8.1, R22.1
unnamed: Q10.1 (B), R26.2, R27.2
unnamed: C9.1, R25.1
unnamed: Q11.1 (B), R29.2, R30.2
unnamed: C10.1, R28.1
unnamed: Q12.1 (B), R32.2, R33.2
unnamed: C11.1, R31.1
unnamed: Q13.1 (B), R35.2, R36.2
unnamed: C12.1, R34.1
unnamed: Q14.1 (B), R38.2, R39.2
unnamed: C13.1, R37.1
unnamed: Q15.1 (B), R44.2, R45.2
unnamed: C14.1, R43.1
unnamed: Q16.1 (B), R47.2, R48.2
unnamed: C15.1, R46.1
unnamed: Q2.1 (B), R41.2, R42.2
unnamed: C20.1, R40.1
unnamed: IC1.4 (G2A), IC1.5 (G2B), R50.2
unnamed: IC4.6 (INH), R51.2
unnamed: IC2.4 (G2A), IC2.5 (G2B), R53.2
unnamed: IC5.6 (INH), R54.2
unnamed: IC3.42 (VBUS), R58.2
unnamed: C16.1, R60.1, R61.2
unnamed: R62.2, TCH0.1
unnamed: R63.2, TCH0.2
unnamed: R64.2, TCH0.3
unnamed: R65.2, TCH0.4
unnamed: R66.2, TCH0.5
unnamed: R67.2, TCH0.6
unnamed: R68.2, TCH0.7
unnamed: R69.2, TCH0.8
unnamed: R70.2, TCH0.9
unnamed: R71.2, TCH0.10
unnamed: R72.2, TCH0.11
unnamed: R74.2, TCH1.2
unnamed: R76.2, TCH1.4
unnamed: R78.2, TCH1.6
unnamed: R80.2, TCH1.8
unnamed: R82.2, TCH1.10
unnamed: R73.2, TCH1.1
unnamed: R75.2, TCH1.3
unnamed: R77.2, TCH1.5
unnamed: R79.2, TCH1.7
unnamed: R81.2, TCH1.9
unnamed: R83.2, TCH1.11
unnamed: C23.1, IC6.4 (BYPASS)
unnamed: R85.1, R86.2
unnamed: Q17.B, R87.2
unnamed: Q17.C, SG1.- (2)
unnamed: C41.1, R88.1
unnamed: C42.1, R89.1
unnamed: C43.1, R90.1
unnamed: C44.1, R91.1
unnamed: C45.1, R92.1
unnamed: C46.1, R93.1
unnamed: C47.1, R94.1
unnamed: C48.1, R95.1
unnamed: C49.1, R96.1
unnamed: C50.1, R97.1
unnamed: C51.1, R98.1
unnamed: C52.1, R99.1
unnamed: C53.1, R100.1
unnamed: C54.1, R101.1
unnamed: C55.1, R102.1
unnamed: C56.1, R103.1
unnamed: C57.1, R104.1
unnamed: C58.1, R105.1
unnamed: C59.1, R106.1
unnamed: C60.1, R107.1
unnamed: C61.1, R108.1
unnamed: C62.1, R109.1
unnamed: C63.1, R110.1
unnamed: C64.1, R111.1
unnamed: C65.1, R112.1
unnamed: C66.1, R113.1
unnamed: C67.1, R114.1
unnamed: C68.1, R115.1
unnamed: C69.1, R116.1
unnamed: C70.1, R117.1
unnamed: C71.1, R118.1
unnamed: C72.1, R119.1
unnamed: C73.1, R120.1
unnamed: C74.1, R121.1
unnamed: C75.1, R122.1
unnamed: C76.1, R123.1
unnamed: C77.1, R124.1
unnamed: C78.1, R125.1
unnamed: C79.1, R126.1
unnamed: C80.1, R127.1
unnamed: C81.1, R128.1
unnamed: C82.1, R129.1
unnamed: C83.1, R130.1
unnamed: C84.1, R131.1
unnamed: C85.1, R132.1
unnamed: C86.1, R133.1
unnamed: C87.1, R134.1
unnamed: C88.1, R135.1
OSCI: C22.1, IC3.30 (OSCI), XTAL1.1
OSCO: C21.1, IC3.31 (OSCO), XTAL1.2
PGEC: IC3.22 (PGEC1), JP1.5
PGED: IC3.21 (PGED1), JP1.4
R0: D17.A, LED0.1, R88.2, U$1.5 (OUTR0)
R1: D20.A, LED0.4, R91.2, U$1.8 (OUTR1)
R2: D23.A, LED0.7, R94.2, U$1.11 (OUTR2)
R3: D26.A, LED0.10, R97.2, U$1.14 (OUTR3)
R4: D29.A, LED1.1, R100.2, U$1.17 (OUTR4)
R5: D32.A, LED1.4, R103.2, U$1.20 (OUTR5)
R6: D35.A, LED1.7, R106.2, U$1.23 (OUTR6)
R7: D38.A, LED1.10, R109.2, U$1.26 (OUTR7)
R8: D41.A, LED2.1, R112.2, U$2.5 (OUTR0)
R9: D44.A, LED2.4, R115.2, U$2.8 (OUTR1)
R10: D47.A, LED2.7, R118.2, U$2.11 (OUTR2)
R11: D50.A, LED2.10, R121.2, U$2.14 (OUTR3)
R12: D53.A, LED3.1, R124.2, U$2.17 (OUTR4)
R13: D56.A, LED3.4, R127.2, U$2.20 (OUTR5)
R14: D59.A, LED3.7, R130.2, U$2.23 (OUTR6)
R15: D62.A, LED3.10, R133.2, U$2.26 (OUTR7)
RAEN: IC1.6 (G1), IC3.12 (RA10), R49.2
RBEN: IC2.6 (G1), IC3.34 (RA4), R52.2
ROW0: D1.C, Q1.3 (C), R1.2, ROW1.1
ROW0EN_: IC1.15 (Y0), R2.1
ROW1: D2.C, Q2.3 (C), R40.2, ROW1.2
ROW1EN_: IC1.14 (Y1), R41.1
ROW2: D3.C, Q3.3 (C), R4.2, ROW1.3
ROW2EN_: IC1.13 (Y2), R5.1
ROW3: D4.C, Q4.3 (C), R7.2, ROW1.4
ROW3EN_: IC1.12 (Y3), R8.1
ROW4: D6.C, Q6.3 (C), R13.2, ROW1.5
ROW4EN_: IC1.11 (Y4), R14.1
ROW5: D5.C, Q5.3 (C), R10.2, ROW1.6
ROW5EN_: IC1.10 (Y5), R11.1
ROW6: D7.C, Q7.3 (C), R16.2, ROW1.7
ROW6EN_: IC1.9 (Y6), R17.1
ROW7: D8.C, Q8.3 (C), R19.2, ROW1.8
ROW7EN_: IC1.7 (Y7), R20.1
ROW8: D10.C, Q10.3 (C), R25.2, ROW2.1
ROW8EN_: IC2.15 (Y0), R26.1
ROW9: D11.C, Q11.3 (C), R28.2, ROW2.3
ROW9EN_: IC2.14 (Y1), R29.1
ROW10: D12.C, Q12.3 (C), R31.2, ROW2.4
ROW10EN_: IC2.13 (Y2), R32.1
ROW11: D14.C, Q14.3 (C), R37.2, ROW2.5
ROW11EN_: IC2.12 (Y3), R38.1
ROW12: D15.C, Q15.3 (C), R43.2, ROW2.7
ROW12EN_: IC2.11 (Y4), R44.1
ROW13: D16.C, Q16.3 (C), R46.2, ROW2.8
ROW13EN_: IC2.10 (Y5), R47.1
ROW14: D9.C, Q9.3 (C), R22.2, ROW2.2
ROW14EN_: IC2.9 (Y6), R23.1
ROW15: D13.C, Q13.3 (C), R34.2, ROW2.6
ROW15EN_: IC2.7 (Y7), R35.1
RSEL0: IC1.1 (A), IC2.1 (A), IC3.13 (RA7)
RSEL1: IC1.2 (B), IC2.2 (B), IC3.32 (RA8)
RSEL2: IC1.3 (C), IC2.3 (C), IC3.35 (RA9)
TMUX0: IC3.11 (AN11), IC4.3 (Y)
TMUX1: IC3.14 (AN10), IC4.13 (X)
TMUX2: IC3.24 (AN5), IC5.3 (Y)
TMUX3: IC3.25 (AN6), IC5.13 (X)
TOUCH0: IC4.1 (Y0), R62.1
TOUCH1: IC4.5 (Y1), R63.1
TOUCH2: IC4.2 (Y2), R64.1
TOUCH3: IC4.4 (Y3), R65.1
TOUCH4: IC4.12 (X0), R66.1
TOUCH5: IC4.14 (X1), R67.1
TOUCH6: IC4.15 (X2), R68.1
TOUCH7: IC4.11 (X3), R69.1
TOUCH8: IC3.15 (AN9), R70.1
TOUCH9: IC3.20 (AN1), R71.1
TOUCH10: IC3.23 (AN4), R72.1
TOUCH11: IC5.1 (Y0), R73.1
TOUCH12: IC5.5 (Y1), R74.1
TOUCH13: IC5.2 (Y2), R75.1
TOUCH14: IC5.4 (Y3), R76.1
TOUCH15: IC5.12 (X0), R77.1
TOUCH16: IC5.14 (X1), R78.1
TOUCH17: IC5.15 (X2), R79.1
TOUCH18: IC5.11 (X3), R80.1
TOUCH19: IC3.26 (AN7), R81.1
TOUCH20: IC3.27 (AN8), R82.1
TOUCH21: IC3.36 (AN12), R83.1
V+: C35.+, IC7.3 (IN), J1.1, R84.1
VBUS: R57.2, R58.1, X1.1
VDDCORE: C38.1, C92.1, IC3.7 (VDDCORE)
VREF+: IC3.19 (VREF+), R87.1

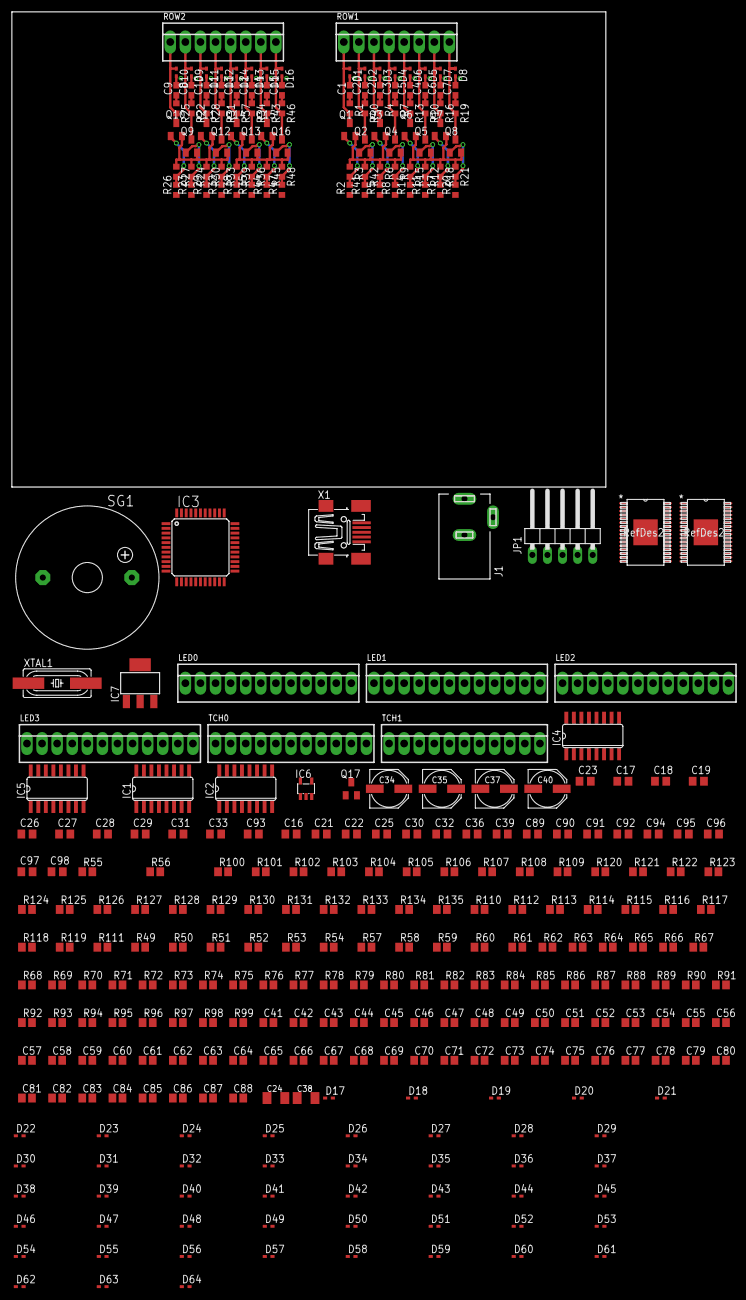
[picture p4: board RowDriver4.brd from above]

Board: 2 copper layers, 100.0 x 88.6 mm, 336 parts (0 on the bottom side), 251 nets.
