mattthebaker/ewall-board/(commit log)

2012-12-08 Added board files from local copy.
    [ClimbingWallController.sch, LED Array.sch, LineDriver.sch]
2012-12-26 Created separate schematics for Row and Column Driver circuits. Added arrayed row and column noise filtering circuits. Added decoupling caps for ICs. Added voltage regulators for 3.3 and 5v rails. Ad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
    [ClimbingWallController.sch, ColumnDriver.sch, RowDriver.sch]
2013-01-01 Implemented full schematic and filled in component values. Schematic is 95% complete, layout may commence.
    [ClimbingWallController.sch]
2013-01-06 Added footprint for LED driver: HTSSOP-32 PowerPad. Cleaned up unnecessary symbols, packages, and devices in library.
2013-01-07 Cleaned up library further. Picked PNP row switch. Converted placeholder RC values with standard values. Added some part documentation.
    [ClimbingWallController.sch]
2013-01-09 Cleaned up all ERC errors in the schematic.
    [ClimbingWallController.sch]
2013-01-10 Created initial main board. Created layout for row driver, and tiled it. The new board and schematic files for the row driver are intermediate steps.
    [ClimbingWallController.brd, ClimbingWallController.sch, RowDriver.brd, RowDriver2.brd, RowDriver2.sch, RowDriver3.brd, RowDriver3.sch, RowDriver4.brd]
2013-01-11 Iterated through a few possible board floorplans. Routing will be incredibly tight, but I thought of a few possibilities that ease those concerns.
    [ClimbingWallController.brd, ClimbingWallController.sch, RowDriver4.brd, RowDriver4.sch]
2013-01-12 Completed most of the column driver routing.
    [ClimbingWallController.brd, ClimbingWallController.sch]
2013-01-14 Completed row/column routing.
    [ClimbingWallController.brd]
2013-01-19 Made progress on layout.
    [ClimbingWallController.brd, ClimbingWallController.sch]
2013-01-20 Completed routing of all circuit board elements. Created ground fills, and stitched everything together. Need to review sensitive signal coupling and review decoupling paths. Need to verify footprint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
    [ClimbingWallController.brd, ClimbingWallController.sch]
2013-01-20 Cleaned up floating ratsnest wires. Cleaned up DRC Errors. Need to check DRC with SEEED's rule set.
    [ClimbingWallController.brd, ClimbingWallController.sch]
2013-01-21 DRC Passed with SEEED Rules. Added extra input to touch connector because 11-socket parts aren't available. Fixed 5v regulator pin out, and added PCB heat sink. Messed with device attributes for manu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
    [ClimbingWallController.brd, ClimbingWallController.sch]
2013-01-21 Increased LED Driver power pad to recommended specs. Exported BOM, massaged, and identified parts at digikey.csv. Setup a Digikey BOM.
    [ClimbingWallController.brd, ClimbingWallController.sch, climbingwallcontroller.csv, digikey.csv]
2013-01-22 Optimized LED Driver footprint and paste mask to match the datasheet. Optimized a few signal routes to reduce noise coupling. Reviewed trace coupling on sensitive nodes. (Layout is good).
    [ClimbingWallController.brd, ClimbingWallController.sch]
2013-01-23 Improved 5v power routing for etching concerns.
    [ClimbingWallController.brd]
2013-01-24 Added Logos to board. Cleaned up part names on board. Fixed LED driver part name.
    [ClimbingWallController.brd, ClimbingWallController.sch]
2013-01-24 Added gerber files to repository.
    [ClimbingWallController.GBL, ClimbingWallController.GBO, ClimbingWallController.GBP, ClimbingWallController.GBS, ClimbingWallController.GTL, ClimbingWallController.GTO, ClimbingWallController.GTP, ClimbingWallController.GTS]
2013-03-25 Updated NC status on column clamp diodes. Added new datasheet.
    [ClimbingWallController.brd, ClimbingWallController.sch]
